superclpvp/Satelite-Seoil/2 Semestre/placas do satelite/Universal (placa pronta)/v1/camada 1- satelite_pcb.png

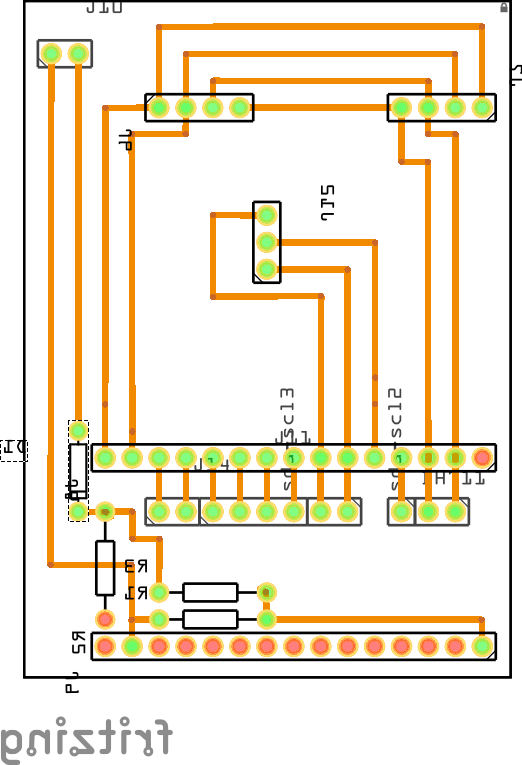
2 Semestre/placas do satelite/Universal (placa pronta)/v1/camada 1- satelite_pcb.png
