superclpvp/Satelite-Seoil/TEST.TXT

Leitura analogica: 1.93 temperatura: 14.45
Leitura analogica: 1.93 temperatura: 14.71
Leitura analogica: 1.95 temperatura: 14.98
Leitura analogica: 1.87 temperatura: 13.56
Leitura analogica: 1.72 temperatura: 10.69
Leitura analogica: 1.54 temperatura: 7.36
Leitura analogica: 1.39 temperatura: 4.48
Leitura analogica: 1.27 temperatura: 1.98
Leitura analogica: 1.17 temperatura: -0.12
Leitura analogica: 1.09 temperatura: -1.86
Leitura analogica: 1.02 temperatura: -3.44
Leitura analogica: 0.97 temperatura: -4.73
Leitura analogica: 0.92 temperatura: -5.94
Leitura analogica: 0.87 temperatura: -7.19
Leitura analogica: 0.84 temperatura: -8.09
Leitura analogica: 0.80 temperatura: -9.02
Leitura analogica: 0.77 temperatura: -9.97
Leitura analogica: 0.74 temperatura: -10.67
Leitura analogica: 0.72 temperatura: -11.39
Leitura analogica: 0.70 temperatura: -12.12
Leitura analogica: 0.68 temperatura: -12.72
Leitura analogica: 0.66 temperatura: -13.33
Leitura analogica: 0.64 temperatura: -13.96
Leitura analogica: 0.62 temperatura: -14.43
Leitura analogica: 0.61 temperatura: -14.92
Leitura analogica: 0.59 temperatura: -15.41
Leitura analogica: 0.58 temperatura: -15.92
Leitura analogica: 0.57 temperatura: -16.26
Leitura analogica: 0.56 temperatura: -16.60
Leitura analogica: 0.55 temperatura: -16.95
Leitura analogica: 0.54 temperatura: -17.31
Leitura analogica: 0.53 temperatura: -17.67
Leitura analogica: 0.52 temperatura: -18.03
Leitura analogica: 0.51 temperatura: -18.22
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
Leitura analogica: 0.44 temperatura: -21.16
Leitura analogica: 0.44 temperatura: -21.37
Leitura analogica: 0.44 temperatura: -21.37
Leitura analogica: 0.44 temperatura: -21.37
Leitura analogica: 0.44 temperatura: -21.37
Leitura analogica: 0.44 temperatura: -21.58
