superclpvp/Satelite-Seoil/satelite.pdf

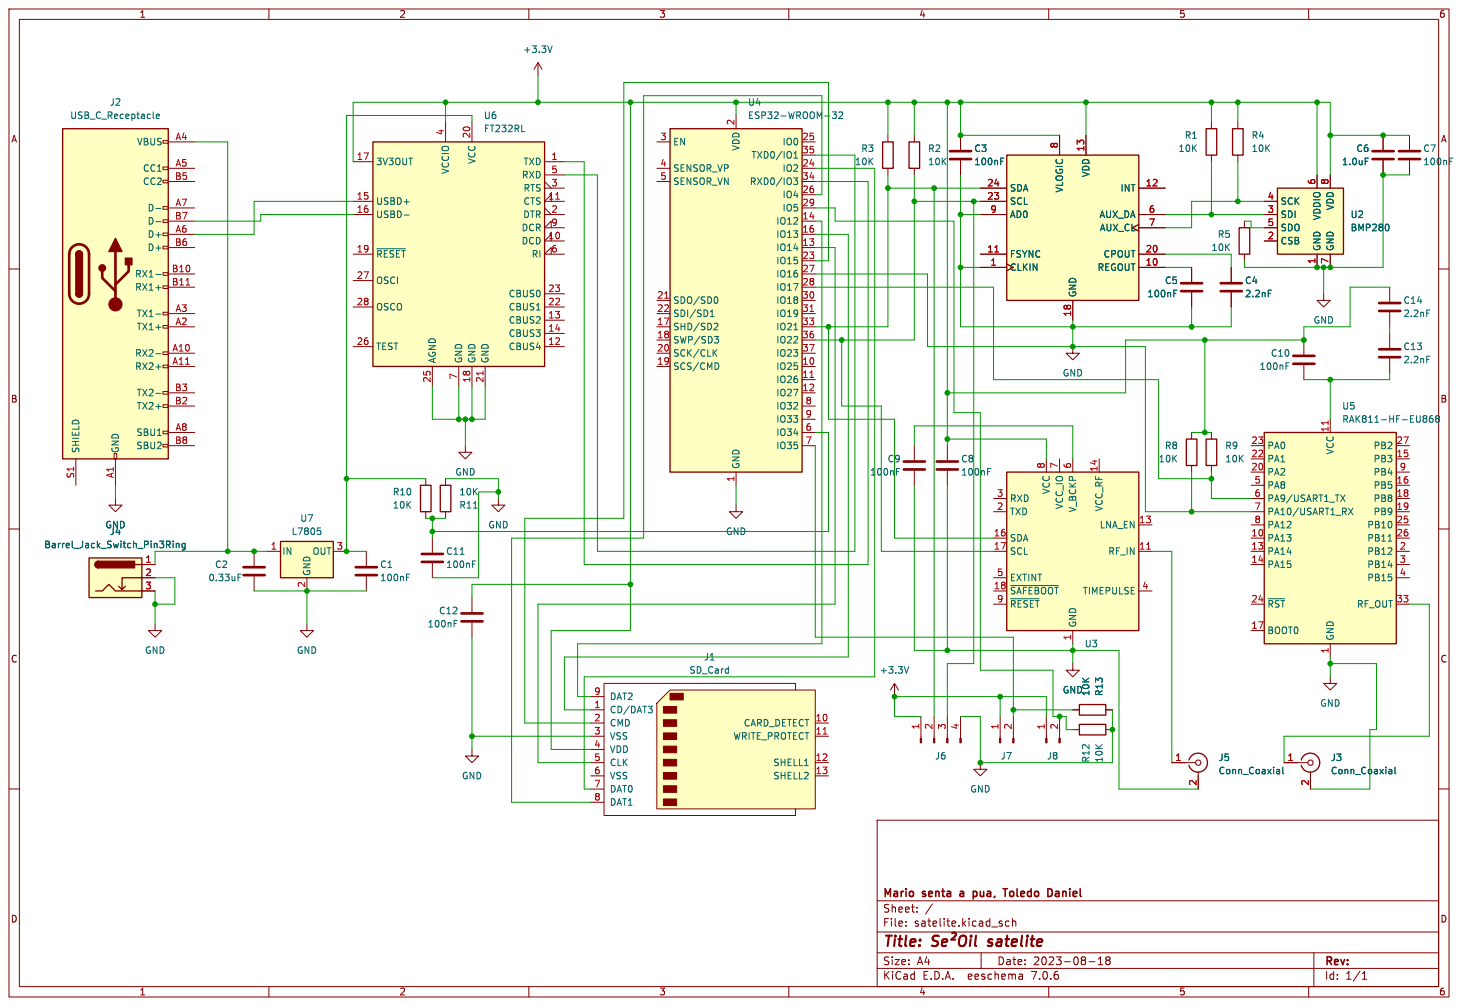
[picture p56: page 1]

2 SCK/CLK 20 SDO/SD0 21 SDI/SD1 22

TXD 1 DCD 10 CTS 11 CBUS4 12 CBUS2 13 CBUS3 14 USBD+ 15 USBD- 16

8 GND 10K R13 CLKIN 1 REGOUT 10 FSYNC 11

1 CSB 2 SDI 3 SCK 4 SDO 5 VDDIO

Id: 1/1 Title: þÿSe²Oil satelite
