superclpvp/Satelite-Seoil/1 Semestre/circuitos/Circuito Eletronico/circuito v1_bb.pdf

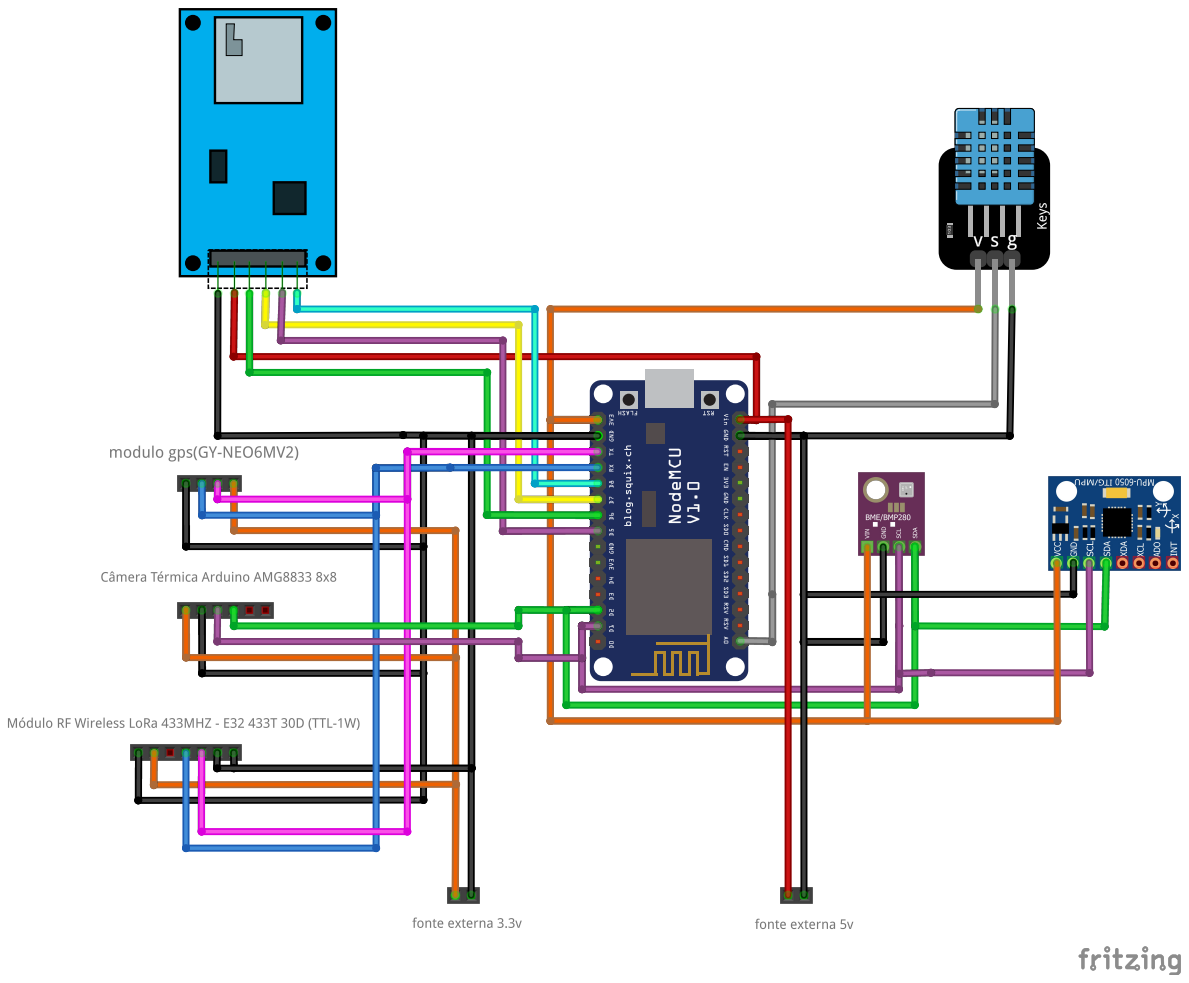
[picture p57: page 1]
