superclpvp/Satelite-Seoil/(list of files, drawings)

Other design files:
1 Semestre/circuitos/Circuito Eletronico/circuito v0.1.fzz
1 Semestre/circuitos/Circuito Eletronico/circuito v0.2.fzz
1 Semestre/circuitos/Circuito Eletronico/circuito v1.fzz
1 Semestre/circuitos/Circuito Eletronico/circuito v2.09.fzz
1 Semestre/circuitos/Circuito Eletronico/circuito v2.fzz
1 Semestre/circuitos/Circuito Eletronico/circuito v3.fzz
1 Semestre/circuitos/Circuito Eletronico/Untitled Sketch 2.fzz
1 Semestre/circuitos/fritzing/circuito v1.fzz
2 Semestre/placas do satelite/Universal (placa pronta)/v1/camada 1 satelite.fzz
2 Semestre/placas do satelite/Universal (placa pronta)/v1/camada 2 satelite.fzz
2 Semestre/placas do satelite/Universal (placa pronta)/v1/design da placa da telemetria.fzz
2 Semestre/placas do satelite/Universal (placa pronta)/Versao atual/camada 1 satelite v2.fzz
2 Semestre/placas do satelite/Universal (placa pronta)/Versao atual/camada 1-3 satelite v3.fzz
2 Semestre/placas do satelite/Universal (placa pronta)/Versao atual/camada 1-3 satelite v4.fzz
2 Semestre/placas do satelite/Universal (placa pronta)/Versao atual/camada 1-3 satelite v5.fzz
2 Semestre/placas do satelite/Universal (placa pronta)/Versao atual/camada 1-3 satelite v6.fzz
2 Semestre/placas do satelite/Universal (placa pronta)/Versao atual/camada 2 satelite v2.fzz
