superclpvp/Satelite-Seoil/2 Semestre/placas do satelite/PCB (precisa revisar)/Satelite industria(Não simulado)/satelite.kicad_pcb

## KiCad design 2 Semestre/placas do satelite/PCB (precisa revisar)/Satelite industria(Não simulado)/satelite.kicad_pcb (2024-09-13)

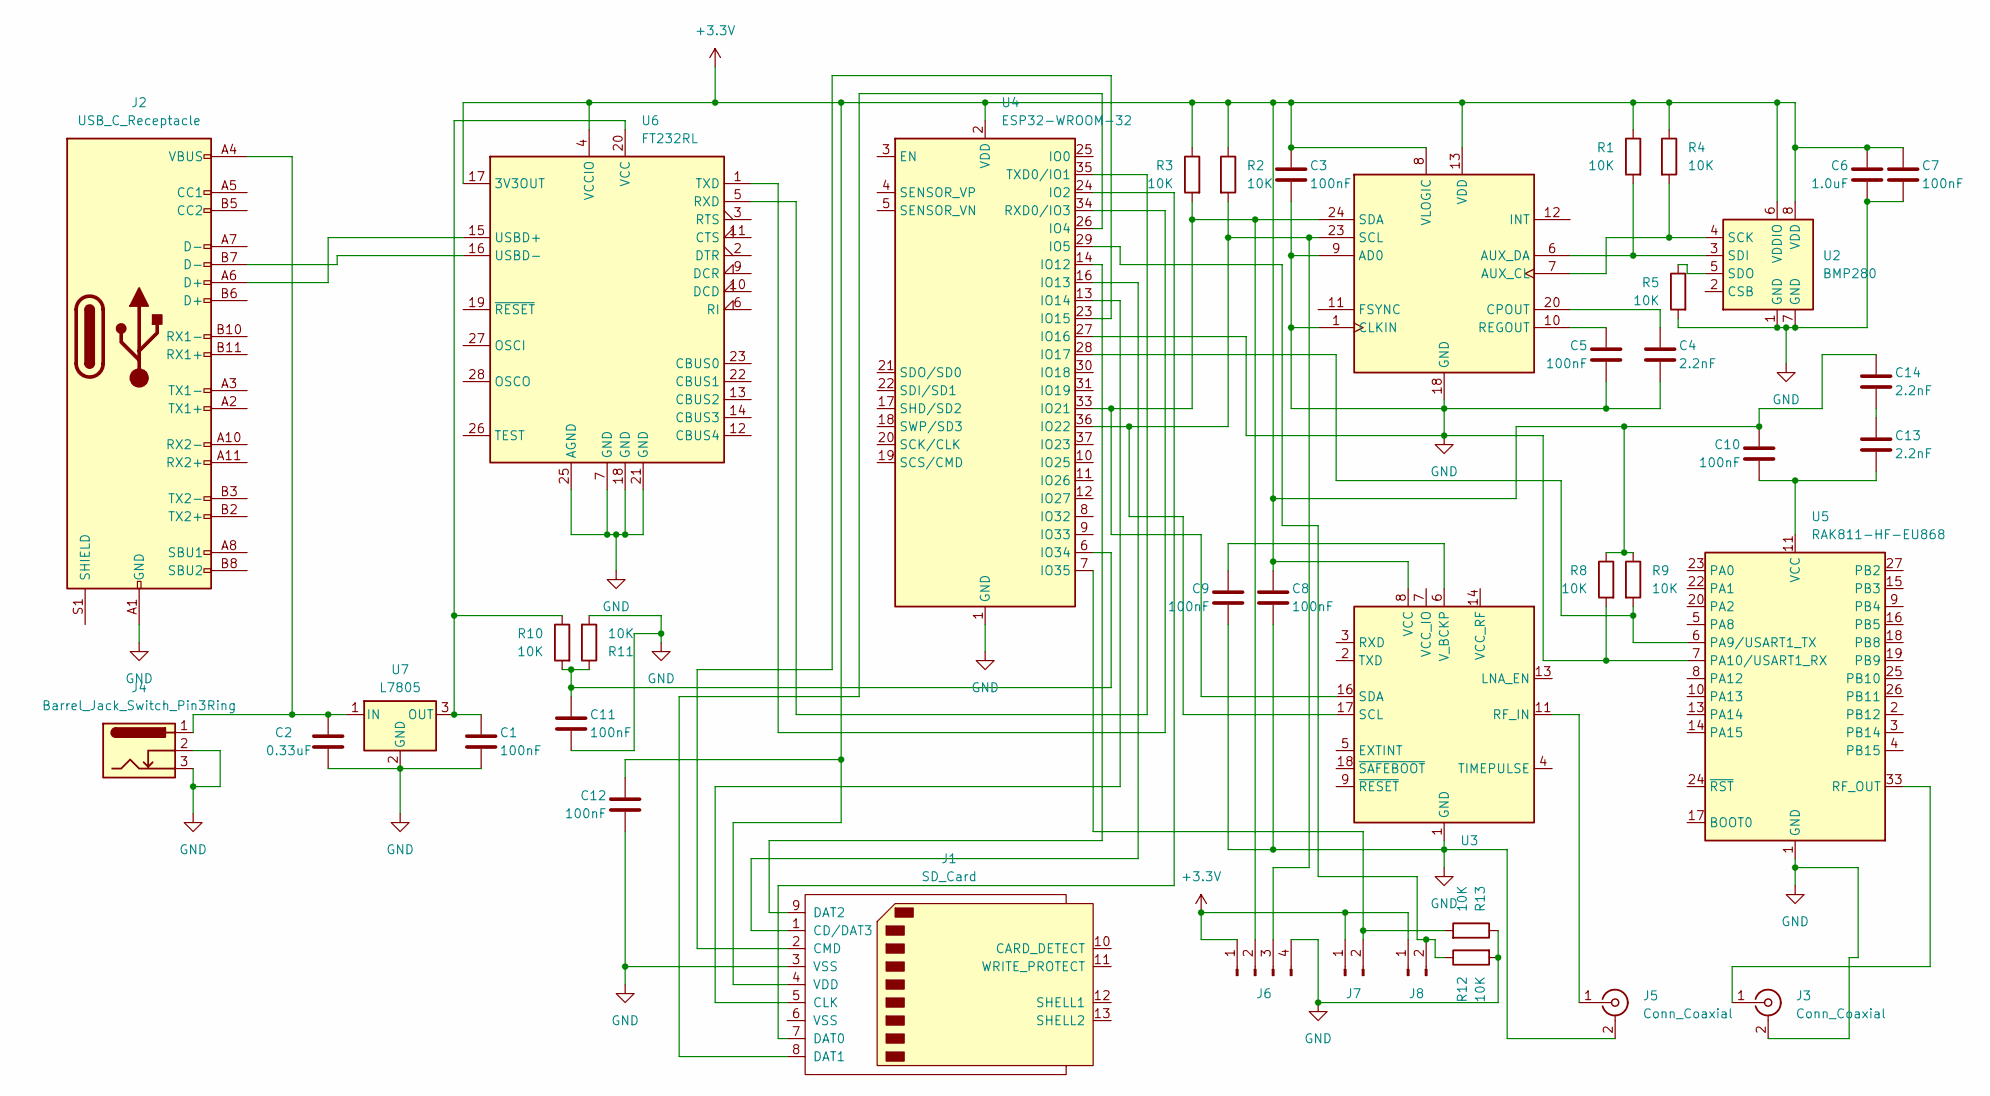
[picture p58: schematic satelite.kicad_sch, Se²Oil satelite]

Parts:
C1, C3, C5, C7, C8, C9, C10, C11, C12: 100nF; C_0805_2012Metric
C2: 0.33uF; C_0201_0603Metric
C4, C13, C14: 2.2nF; C_0201_0603Metric
C6: 1.0uF; C_0201_0603Metric
J1: SD_Card; microSD_HC_Hirose_DM3D-SF
J2: USB_C_Receptacle; USB_C_Receptacle_GCT_USB4085
J3, J5: Conn_Coaxial; U.FL_Hirose_U.FL-R-SMT-1_Vertical
J4: Barrel_Jack_Switch_Pin3Ring; BarrelJack_Horizontal
J6: Conn_01x04_Pin; PinHeader_1x04_P1.00mm_Vertical
J7, J8: Conn_01x02_Pin; PinHeader_1x02_P1.00mm_Vertical
R1, R2, R3, R4, R5, R8, R9, R10, R11, R12, R13: 10K; R_0805_2012Metric
U1: MPU-6050; InvenSense_QFN-24_4x4mm_P0.5mm
U2: BMP280; Bosch_LGA-8_2x2.5mm_P0.65mm_ClockwisePinNumbering
U3: MAX-M8Q; ublox_MAX
U4: ESP32-WROOM-32
U5: RAK811-HF-EU868; RAK811
U6: FT232RL; SSOP-28_5.3x10.2mm_P0.65mm
U7: L7805; TO-263-2

Connections:
+3.3V: C3.1, C6.1, C7.1, C8.1, C10.1, C12.1, C14.1, J1.4 (VDD), J6.1, J7.1, J8.1, R1.1, R2.1, R3.1, R4.1, R8.1, R9.1, U1.8 (VLOGIC), U1.13 (VDD), U2.6 (VDDIO), U2.8 (VDD), U3.8 (VCC), U4.2 (VDD), U6.4 (VCCIO), U6.17 (3V3OUT)
GND: C1.2, C2.2, C3.2, C4.2, C5.2, C6.2, C7.2, C8.2, C9.2, C11.2, C12.2, J1.3 (VSS), J2.A1 (GND), J2.A12 (GND), J2.B1 (GND), J2.B12 (GND), J3.2 (Ext), J4.2, J4.3, J5.2 (Ext), J6.4, R5.2, R8.2, R11.2, R12.2, R13.1, U1.1 (CLKIN), U1.9 (AD0), U1.18 (GND), U2.1 (GND), U2.7 (GND), U3.1 (GND), U3.10 (GND), U3.12 (GND), U4.1 (GND), U4.15 (GND), U4.27 (IO16), U4.38 (GND), U4.39 (GND), U5.1 (GND), U5.7 (PA10/USART1_RX), U5.12 (GND), U5.21 (GND), U5.28 (GND), U5.29 (GND), U5.30 (GND), U5.31 (GND), U5.32 (GND), U5.34 (GND), U6.7 (GND), U6.18 (GND), U6.21 (GND), U6.25 (AGND), U7.2 (GND)
unnamed: C13.1, C14.2
unnamed: J1.1 (CD/DAT3), U4.16 (IO13)
unnamed: J1.5 (CLK), U4.13 (IO14)
unnamed: J1.2 (CMD), U4.23 (IO15)
unnamed: J1.7 (DAT0), U4.24 (IO2)
unnamed: J1.8 (DAT1), U4.26 (IO4)
unnamed: J1.9 (DAT2), U4.14 (IO12)
unnamed: J3.1 (In), U5.33 (RF_OUT)
unnamed: J5.1 (In), U3.11 (RF_IN)
unnamed: J6.2, R3.2, U1.24 (SDA), U3.16 (SDA), U4.33 (IO21)
unnamed: J6.3, R2.2, U1.23 (SCL), U3.17 (SCL), U4.36 (IO22)
unnamed: J7.2, R13.2, U4.7 (IO35)
unnamed: J8.2, R12.1, U4.29 (IO5)
unnamed: R4.2, U1.7 (AUX_CL), U2.4 (SCK)
unnamed: R1.2, U1.6 (AUX_DA), U2.3 (SDI)
unnamed: C4.1, U1.20 (CPOUT)
unnamed: C5.1, U1.10 (REGOUT)
unnamed: R5.1, U2.5 (SDO)
unnamed: C9.1, U3.6 (V_BCKP)
unnamed: R9.2, U4.28 (IO17), U5.6 (PA9/USART1_TX)
unnamed: C11.1, R10.2, R11.1, U4.6 (IO34)
unnamed: U4.34 (RXD0/IO3), U6.1 (TXD)
unnamed: U4.35 (TXD0/IO1), U6.5 (RXD)
unnamed: C10.2, C13.2, U5.11 (VCC)
unnamed: J2.A6 (D+), U6.15 (USBD+)
unnamed: J2.B7 (D-), U6.16 (USBD-)
unnamed: C1.1, R10.1, U6.20 (VCC), U7.3 (OUT)
unnamed: C2.1, J2.A4 (VBUS), J2.A9 (VBUS), J2.B4 (VBUS), J2.B9 (VBUS), J4.1, U7.1 (IN)

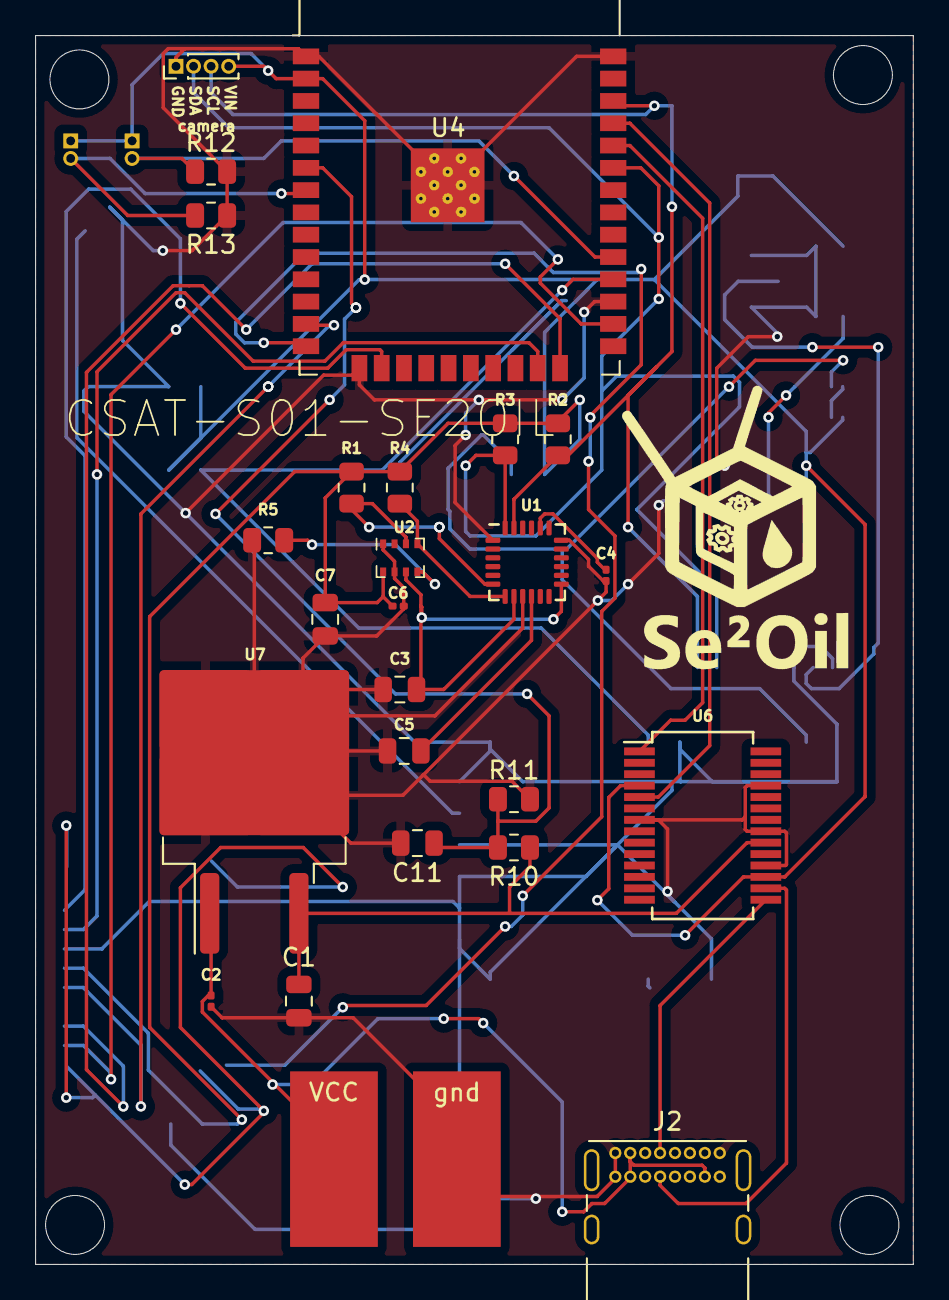
[picture p59: board satelite.kicad_pcb from above]

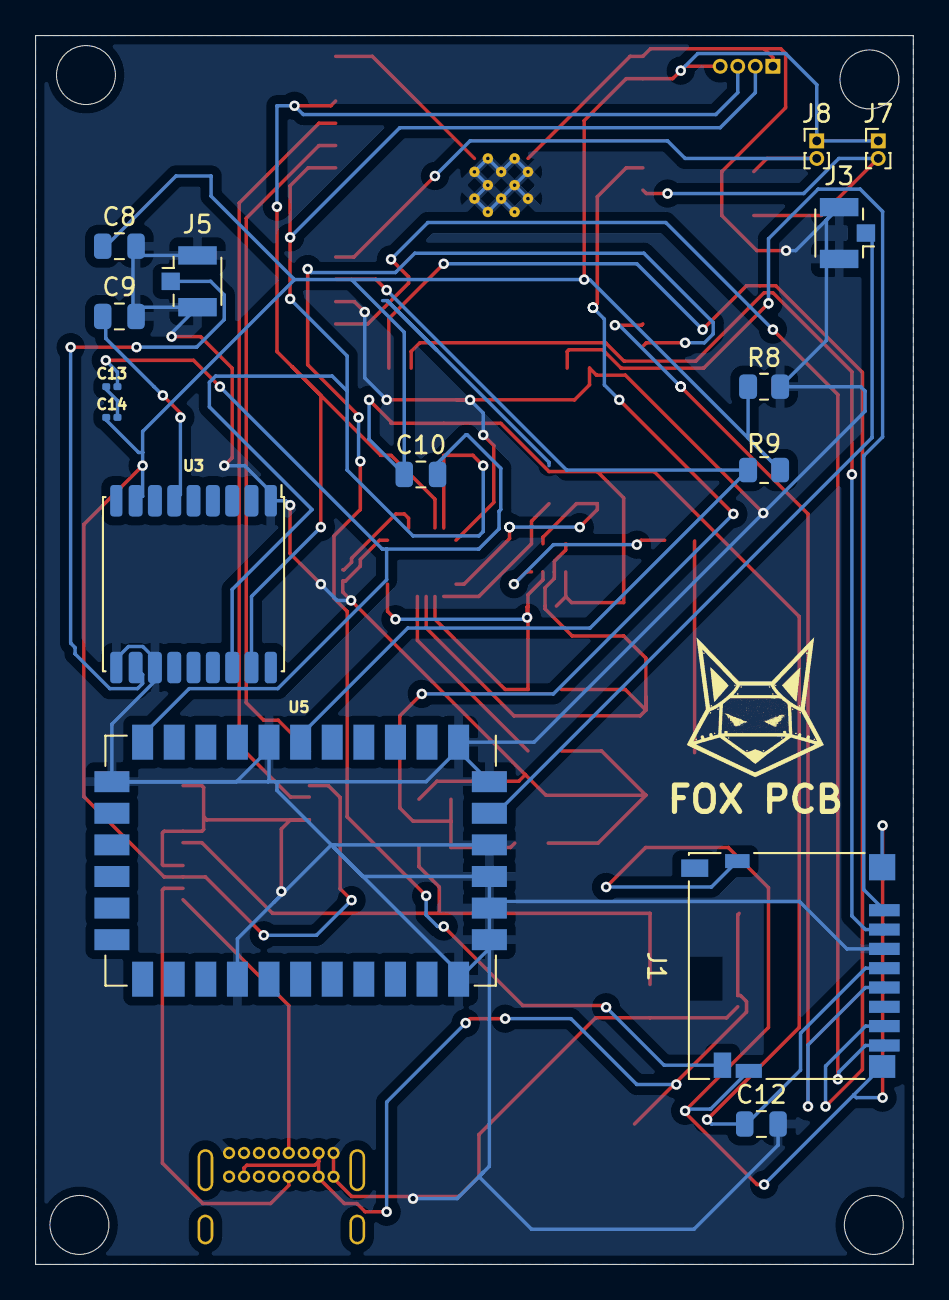
[picture p60: board satelite.kicad_pcb from below]

Board: 2 copper layers, 50.0 x 70.0 mm, 41 parts (16 on the bottom side), 30 nets.

Other parts of the board:
FOX PCB: LOGO; raposoBx10
VCC: SolderWirePad_1x01_SMD_5x10mm
gnd: SolderWirePad_1x01_SMD_5x10mm
