superclpvp/Satelite-Seoil/2 Semestre/Codigos/Sistema Operacional/SeoilSO_v4-json/SeoilSO_v4-json.ino

//=========================Bibliotecas===============================//

#include <MPU6050_tockn.h> //biblioteca para o Giroscopio
#include <Wire.h>// biblioteca para comunicação Serial I2C
#include <Adafruit_Sensor.h> //Biblioteca suporte para sensores da marca Adafruit
#include <Adafruit_BMP280.h> //Biblioteca do Barômetro
#include <SD.h> //Biblioteca do cartão SD
#include <SPI.h> //Biblioteca para comunicação serial SPI do cartão SD
#include <TinyGPS++.h> //Biblioteca Do GPS
#include <SoftwareSerial.h> //Biblioteca para comunicação serial TX e RX
#include <Arduino_KNN.h> //Biblioteca Para O algoritmo KNN
#include <ESP8266WiFi.h>
#include <WiFiClient.h>
#include <ESP8266WebServer.h>
#include <ESP8266mDNS.h>

//======================bibliotecas personalizadas(download: )==================//

#include <MLX90640_API.h> 
#include <MLX90640_I2C_Driver.h> //bibliotecas da camêra termica (MLX90640_DaniMaster.zip)

//=========================variaveis Globbais===============================//

//--------KNN-----------//
const int INPUTS = 2; //Numero de dados para o treino do knn
const int CLASSES = 2;// duas classes - 0 agua _ 1 oleo
const int K = 3;// valor de quantas casas o knn vai analisar para definir os valores de agua e oleo
int vezes = 3;

float pixel[2];

String sat_mode = "0"; //variavel que muda o estado do satélite 
bool camera_conectado = false;
bool GPS_conectado = false;
bool Barometro_conectado = false;
bool giroscopio_conectado = false;
bool Lora_conectado = false;
bool sd_conectado = false;


//=======================Sensores========================= //

//-------------------GPS-----------------------//
int GPSBaud = 9600;
float All_sat[8];
double ALL_Gyro[6];

float SD_Analise[3];
float Em_Analise[3];

String Resultado = "null";

String TextGps = "null";
//----------eixos do giroscopio-------------//
double vertical;
double horizontal;
double eixoz;

double altitude;
//--------objetos--------//
#define CS_PIN  D8 // pino do Chip Select(CS) do Cartão SD

KNNClassifier knn(INPUTS); // Objeto KNN

TinyGPSPlus gps;
SoftwareSerial gpsSerial(D4, D0);

MPU6050 mpu6050(Wire);
Adafruit_BMP280 bmp; //OBJETO DO TIPO Adafruit_BMP280 (I2C)

//----------//
uint32_t start; 
uint32_t stop;
//----------//

//-----------Camera termica------------//
const int MLX90640_address = 0x33;

float mlx90640To[768];
paramsMLX90640 mlx90640;

#define TA_SHIFT 8 //Default shift for MLX90640 in open air


const char* ssid = "Vegana";
const char* password = "yanna123";

ESP8266WebServer server(80);

//----------//

void handleRoot() {

  String textoHTML;
  textoHTML = "<link rel=stylesheet href=https://www.w3schools.com/w3css/4/w3.css>";
//textoHTML += "<style>table, td, th {th {text-align: left;}</style>";
  textoHTML += "<body class=w3-light-green>";
  textoHTML += "<h1><p align=center><b>Se<sup>2</sup>Oil: Satelite de Monitoramento de Manchas de oleo em rios, lagos e lagoas</b></p></h1></br>";
  //textoHTML += "<h1><p align=center>Satelite de Monitoramento de Manchas de oleo em rios, lagos e lagoas</p></h1></br>";
  textoHTML += "<p align=center></c><img src = https://v1.padlet.pics/1/image.webp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 width=200 height=200 />";  textoHTML += "<img src=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 width=200 height=200></p>";
  textoHTML += "</br>";
  textoHTML += "<h2><p align=center><b>Dados do satelite</b></p></h2>";
  textoHTML += "</br>";
  textoHTML += "<table border=1 text-aling=left> <tr> <th> Data </th><th> Hora </th><th> Posicao Geografica</th> <th>Temperatura</th><th>Pressao</th><th>Bateria</th><th>Giroscopio</th> <th> Dados da camera termica</th> </tr>";
  textoHTML += ler_o_Send();
  textoHTML += "</table>";
  //textoHTML += "Clique para atualizar os dados</br>";
  //textoHTML +="BOTAO"; 
  //textoHTML +="</body>";
  server.send(200, "text/html", textoHTML);
}

void handleNotFound(){
  String message = "File Not Found\n\n";
  message += "URI: ";
  message += server.uri();
  message += "\nMethod: ";
  message += (server.method() == HTTP_GET)?"GET":"POST";
  message += "\nArguments: ";
  message += server.args();
  message += "\n";
  for (uint8_t i=0; i<server.args(); i++){
    message += " " + server.argName(i) + ": " + server.arg(i) + "\n";
  }
  server.send(404, "text/plain", message);
}

void iniciar_componentes(){
  
  gpsSerial.begin(GPSBaud);
    
  iniciarSD();
  Iniciar_Cam();
  
  mpu6050.begin();
  giroscopio_conectado = true;
  
  
  if(bmp.begin(0x76)){
    Barometro_conectado = true;
  }   


    WiFi.mode(WIFI_STA);
  WiFi.begin(ssid, password);
  Serial.println("");

  // Wait for connection
  while (WiFi.status() != WL_CONNECTED) {
    delay(500);
    Serial.print(".");
  }
  Serial.println("");
  Serial.print("Connected to ");
  Serial.println(ssid);
  Serial.print("IP address: ");
  Serial.println(WiFi.localIP());

  if (MDNS.begin("esp8266")) {
    Serial.println("MDNS responder started");
  }

  server.on("/", handleRoot);

  server.on("/inline", [](){
    server.send(200, "text/plain", "this works as well");
  });

  server.onNotFound(handleNotFound);

  server.begin();
  Serial.println("HTTP server started");
}
//========================setup================================//

void setup() {
  
  Serial.begin(115200); // clock do ESP8266 

  Serial.println("wire begin");
  Wire.begin();
  Wire.setClock(400000); //deixar o clock do wire para 400kHz
  iniciar_componentes(); //tarefa para iniciar os componentes 
  mostrarCOMPnoSerial(); //imprimir no monitor serial os componentes disponiveis
  Telemetria();
  TreinarKnn();

}
//=========================loop=============================//

void loop(){ 

  bool Tarefa_Comprida = false;
//  
//  if(DetectarTirarFoto()){
//    print_Cam_save();
//    Tarefa_Comprida = true;
//  }
//  else{
//    if(LerManager("M1ImgsNProcss") > -1){
//      ProcessarImagem(LerManager("M1ImgsNProcss"));
//      Tarefa_Comprida = true;
//    }
//    else if(LerManager("M2ImgsProcss") > -1 && Tarefa_Comprida == false){
//      Analisar_Imagem_KNN(LerManager("M2ImgsProcss"));
//      Tarefa_Comprida = true;      
//    }
//    
//  }

  server.handleClient();
//  handleRoot();
  Telemetria();
//  Serial.println("a");
}

//========================Tarefas=============================//


void mostrarCOMPnoSerial(){
  Serial.println("camera - " + String(camera_conectado));
  Serial.println("GPS - "+ String(GPS_conectado));
  Serial.println("Barometro - " + String(Barometro_conectado));
  Serial.println("Giroscopio - "+ String(giroscopio_conectado));
  Serial.println("Lora - " + String(Lora_conectado));
  Serial.println("SD card - "+ String(sd_conectado));
}
