superclpvp/Satelite-Seoil/2 Semestre/Codigos/processo_da_camera/processo_da_camera.pde

/*
  Visualizing the MLX90640 Sensor Data using Processing
  By: Nick Poole
  SparkFun Electronics
  Date: June 5th, 2018
  
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
  Feel like supporting our work? Buy a board from SparkFun!
  https://www.sparkfun.com/products/14568
  
  This example is intended as a companion sketch to the Arduino sketch found in the same folder.
  Once the accompanying code is running on your hardware, run this Processing sketch. 
  This Processing sketch will receive the comma separated values generated by the Arduino code and
  use them to generate a thermal image. 
  
  IF this example code generates ArrayOutOfBounds exceptions, double check that you are running
  the correct Teensy example code and try again.
  
  Hardware Connections:
  Attach the Sensor to your Teensy 3.2 or later using
  a Qwiic breadboard cable
*/

import processing.serial.*;

String myString = null;
Serial myPort;  // The serial port

float[] temps = new float[768];
String splitString[] = new String[1000];
float maxTemp = 0;
float minTemp = 500;

// The statements in the setup() function 
// execute once when the program begins
void setup() {
  size(480, 400);  // Size must be the first statement
  noStroke();
  frameRate(30);
  
  // Print a list of connected serial devices in the console
  printArray(Serial.list());
  // Depending on where your sensor falls on this list, you
  // may need to change Serial.list()[0] to a different number
  myPort = new Serial(this, Serial.list()[0], 115200);
  myPort.clear();
  // Throw out the first chunk in case we caught it in the 
  // middle of a frame
  myString = myPort.readStringUntil(13);
  myString = null;
  // change to HSB color mode, this will make it easier to color
  // code the temperature data
  colorMode(HSB, 360, 100, 100);
}

// The statements in draw() are executed until the 
// program is stopped. Each statement is executed in 
// sequence and after the last line is read, the first 
// line is executed again.
void draw() { 
  
  // When there is a sizeable amount of data on the serial port
  // read everything up to the first linefeed
  if(myPort.available() > 5000){
  myString = myPort.readStringUntil(13);
  
  // Limit the size of this array so that it doesn't throw
  // OutOfBounds later when calling "splitTokens"
  if(myString.length() > 4608){
  myString = myString.substring(0, 4608);}
  
  // generate an array of strings that contains each of the comma
  // separated values
  splitString = splitTokens(myString, ",");
  
  // Reset our min and max temperatures per frame
  maxTemp = 0;
  minTemp = 500;
  
  // For each floating point value, double check that we've acquired a number,
  // then determine the min and max temperature values for this frame
  for(int q = 0; q < 768; q++){
    
    if(!Float.isNaN(float(splitString[q])) && float(splitString[q]) > maxTemp){
      maxTemp = float(splitString[q]);
    }else if (!Float.isNaN(float(splitString[q])) && float(splitString[q]) < minTemp){
      minTemp = float(splitString[q]);
    }
    
  }  
  
  // for each of the 768 values, map the temperatures between min and max
  // to the blue through red portion of the color space
  for(int q = 0; q < 768; q++){
    
    if(!Float.isNaN(float(splitString[q]))){
    temps[q] = constrain(map(float(splitString[q]), minTemp, maxTemp, 180, 360),160,360);}
    else{
    temps[q] = 0;
    }
    
  }
  }
  
  
  // Prepare variables needed to draw our heatmap
  int x = 0;
  int y = 0;
  int i = 0;
  background(0);   // Clear the screen with a black background
  
  

  while(y < 360){
  
    
  // for each increment in the y direction, draw 8 boxes in the 
  // x direction, creating a 64 pixel matrix
  while(x < 480){
  // before drawing each pixel, set our paintcan color to the 
  // appropriate mapped color value
  fill(temps[i], 100, 100);
  rect(x,y,15,15);
  x = x + 15;
  i++;
  }
  
  y = y + 15;
  x = 0;
  }
  
  // Add a gaussian blur to the canvas in order to create a rough
  // visual interpolation between pixels.
  filter(BLUR,1);
  
  
  // Generate the legend on the bottom of the screen
  textSize(32);
  
  // Find the difference between the max and min temperatures in this frame
  float tempDif = maxTemp - minTemp; 
  // Find 5 intervals between the max and min
  int legendInterval = round(tempDif / 5); 
  // Set the first legend key to the min temp
  int legendTemp = round(minTemp);
  
  // Print each interval temperature in its corresponding heatmap color
  for(int intervals = 0; intervals < 6; intervals++){
  fill(constrain(map(legendTemp, minTemp, maxTemp, 180, 360),160,360), 100, 100);
  text(legendTemp+"°", 70*intervals, 390);
  legendTemp += legendInterval;
  }
  
} 
