superclpvp/Satelite-Seoil/2 Semestre/Codigos/Sistema Operacional/SeoilSO_v4-json/camera_termica.ino

void print_Cam_save(){
  for(int x = 0; x <= 3; x++){
//    while(All_sat[1] == -999 && All_sat[2] == -999){
      GPS_all_Data();
//    }
  }
  AdicionarImagem();  
  int indexCam = NumeroDeImagens();
 
  String NomeArquivoImagem = "Img" + String(indexCam);
  Saveln(NomeArquivoImagem, String(indexCam));
  Saveln(NomeArquivoImagem,String(All_sat[1]));
  Saveln(NomeArquivoImagem,String(All_sat[2]));
  Saveln(NomeArquivoImagem,String(All_sat[3]));
  Saveln(NomeArquivoImagem,String(All_sat[4]));
  Saveln(NomeArquivoImagem,String(All_sat[5]));
  Saveln(NomeArquivoImagem,String(All_sat[6]));
  Saveln(NomeArquivoImagem,String(All_sat[7]));
  Saveln(NomeArquivoImagem,"");
  Saveln(NomeArquivoImagem,"img");
  
  long startTime = millis();
  for (byte x = 0 ; x < 10 ; x++)
  {
    uint16_t mlx90640Frame[834];
    int status = MLX90640_GetFrameData(MLX90640_address, mlx90640Frame);

    float vdd = MLX90640_GetVdd(mlx90640Frame, &mlx90640);
    float Ta = MLX90640_GetTa(mlx90640Frame, &mlx90640);

    float tr = Ta - TA_SHIFT; //Reflected temperature based on the sensor ambient temperature
    float emissivity = 0.95;

    MLX90640_CalculateTo(mlx90640Frame, &mlx90640, emissivity, tr, mlx90640To);
  }
  long stopTime = millis();

  for (int x = 0 ; x < 768 ; x++)
  {
//    if(x % 32 == 0) {Serial.println();Saveln("imagens"," ");}
    String img = String(mlx90640To[x], 2) + "\t";
    Serial.print(img);
    Save(NomeArquivoImagem,img);
    Save(NomeArquivoImagem,"\t");
  }
  Serial.println("");


  Saveln("imagens","--------------------------------");
  Serial.println("arquivo salvo em");
  Serial.print(NomeArquivoImagem);
  Serial.println("");

  addManager("M1ImgsNProcss" ,indexCam);
  
}
void Iniciar_Cam(){
  Wire.beginTransmission((uint8_t)MLX90640_address);
  
  int status;
  uint16_t eeMLX90640[832];
  status = MLX90640_DumpEE(MLX90640_address, eeMLX90640);

  if (status != 0)
    Serial.println("falha no carregamento dos parametros do sistema");
    
  status = MLX90640_ExtractParameters(eeMLX90640, &mlx90640);

  if (status != 0){
    Serial.println("falha em extrair o parametro");
    camera_conectado = false;
  }
  else{
    camera_conectado = true;
  }
  //MLX90640_SetRefreshRate(MLX90640_address, 0x02); //Set rate to 2Hz
  MLX90640_SetRefreshRate(MLX90640_address, 0x03); //Set rate to 4Hz
  //MLX90640_SetRefreshRate(MLX90640_address, 0x07); //Set rate to 64Hz  


  
}
/*
void print_Cam(){
  
  long startTime = millis();
  for (byte x = 0 ; x < 2 ; x++)
  {
    uint16_t mlx90640Frame[834];
    int status = MLX90640_GetFrameData(MLX90640_address, mlx90640Frame);

    float vdd = MLX90640_GetVdd(mlx90640Frame, &mlx90640);
    float Ta = MLX90640_GetTa(mlx90640Frame, &mlx90640);

    float tr = Ta - TA_SHIFT; //Reflected temperature based on the sensor ambient temperature
    float emissivity = 0.95;

    MLX90640_CalculateTo(mlx90640Frame, &mlx90640, emissivity, tr, mlx90640To);
  }
  long stopTime = millis();

  for (int x = 0 ; x < 768 ; x++)
  {
    if(x % 27 == 0) Serial.println();
    Serial.print(mlx90640To[x], 2);
    Serial.print(",");
  }
  Serial.println("");
  
}*/
