superclpvp/Satelite-Seoil/(notices)

Notices in the files:
2 Semestre/Codigos/processo_da_camera/processo_da_camera.pde:
MIT License: Permission is hereby granted, free of charge, to any person obtaining a copy of this
